Rupakpoddar/ECE-597SD/README.md

# ECE 597SD Team 6
A repository for our ECE 597SD group project
