Rupakpoddar/ECE-597SD/ECE 597SD Project Poster.pdf

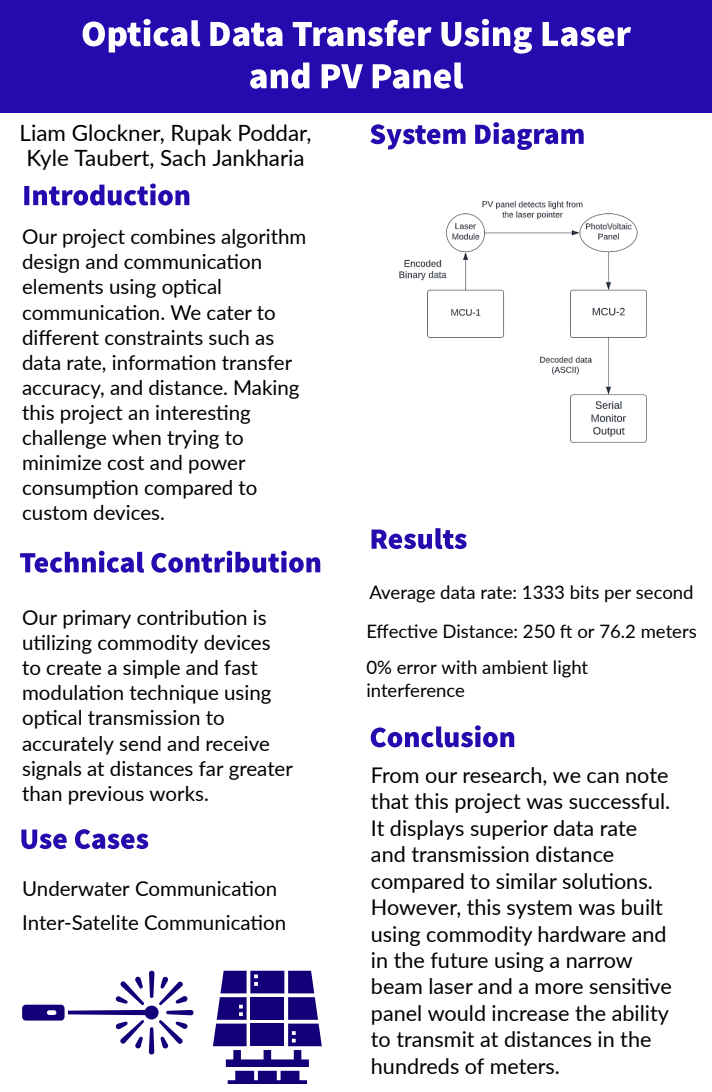
[picture p9: page 1]
Our; devices; create simple; transmission; technique using; optical; utilizing commodity; accurately send; and; receive; signals at distances; greater; than; fast; modulation; and far previous works.; Liam Glockner, Sach; Rupak Poddar,; Kyle Taubert,; Jankharia

Our project combines algorithm
design and communication
elements using optical
communication. We cater to
different constraints such as
data rate, information transfer
accuracy, and distance. Making
this project an interesting
challenge when trying to
minimize cost and power
consumption compared to
custom devices.

Average data rate: 1333 bits per second
Effective Distance: 250 ft or 76.2 meters
0% error with ambient light
interference

primary contribution is

From our research, we can note
that this project was successful.
It displays superior data rate
and transmission distance
compared to similar solutions.
However, this system was built
using commodity hardware and
in the future using a narrow
beam laser and a more sensitive
panel would increase the ability
to transmit at distances in the
hundreds of meters.

Underwater Communication
Inter-Satelite Communication
