Rupakpoddar/ECE-597SD/NEW Project Code/Transmitter/Transmitter.ino

// ECE 597 SD Project

String charToBin(int number)
{
  String binNum = "";
  for (int bit = 6; bit >= 0; bit--)
  {
    binNum += bitRead(number, bit);
  }
  return binNum;
}

int zeroLength = 500;  // 50  // 10 // 8  // 4  // 1  // 500
int oneLength = zeroLength*2;

void setup() {
  pinMode(13, OUTPUT);
  Serial.begin(115200);
}

void loop() {
  char ch;
  if(Serial.available()){
    ch = Serial.read();
    flashLaser(charToBin(ch));
    delayMicroseconds(zeroLength*3);
  }
}

void flashLaser(String BinaryChar)
{
  for (int i=0; i<7; i++){
    if(BinaryChar[i] == '0'){
      zero();
    } else if (BinaryChar[i] == '1'){
      one();
    }
  }
}

void zero()
{
  digitalWrite(13, HIGH);
  delayMicroseconds(zeroLength);
  digitalWrite(13, LOW);
  delayMicroseconds(zeroLength);
}

void one()
{
  digitalWrite(13, HIGH);
  delayMicroseconds(oneLength);
  digitalWrite(13, LOW);
  delayMicroseconds(zeroLength);
} 
